fhunleth/scratchcc/robot/cad/sidestrip.pdf

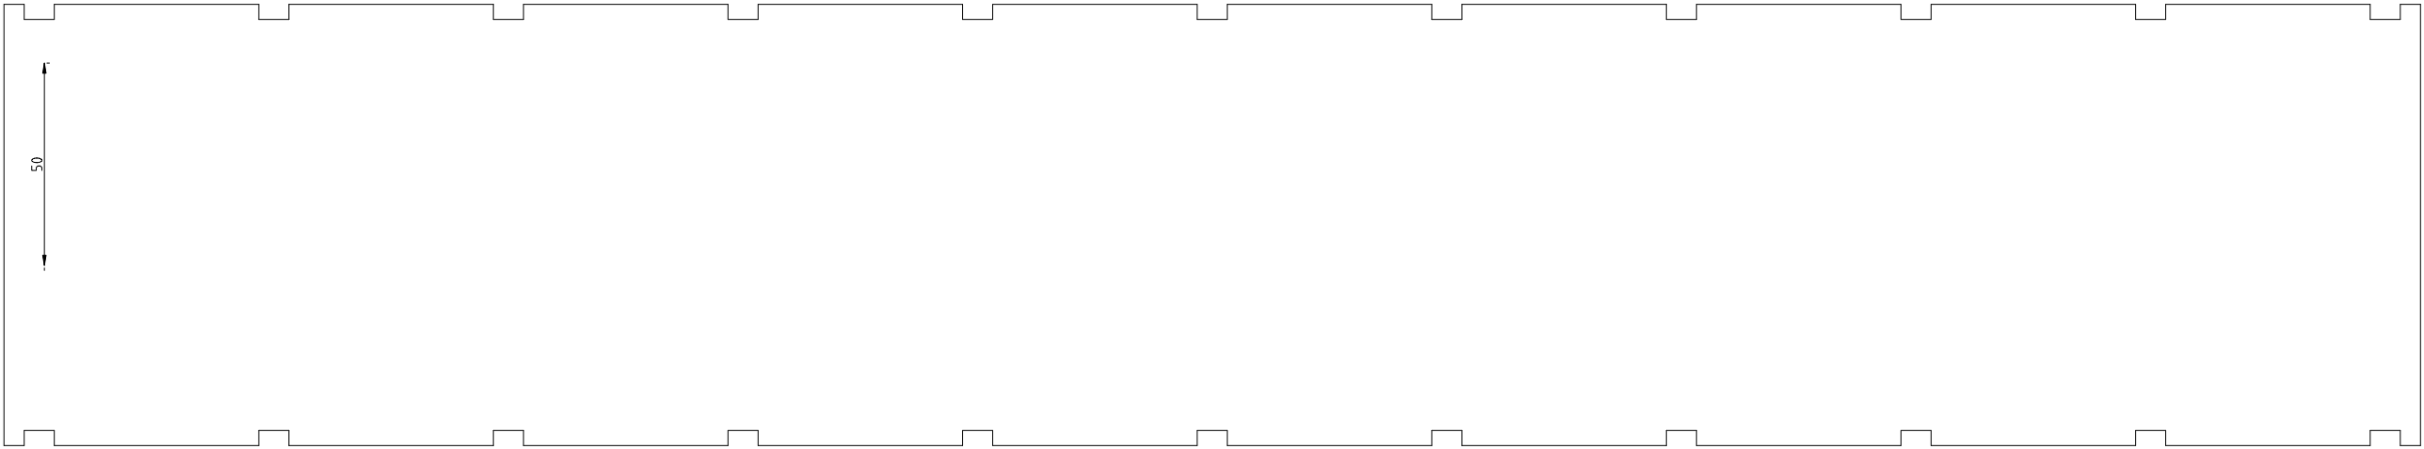
[picture p1: figure]
