fhunleth/scratchcc/robot/cad/batteryholder.dxf

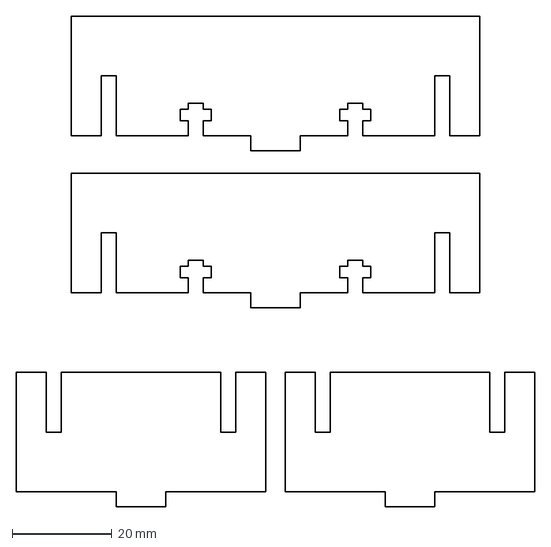
[picture p2: CAD file, 2014-07-11]
robot/cad/batteryholder.dxf
104.0 x 98.5 mm
