fhunleth/scratchcc/robot/cad/sidestrip.dxf

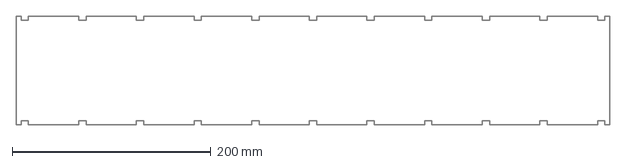
[picture p3: CAD file, 2014-07-11]
robot/cad/sidestrip.dxf
598.1 x 109.1 mm
