fhunleth/scratchcc/robot/cad/robottop.dxf

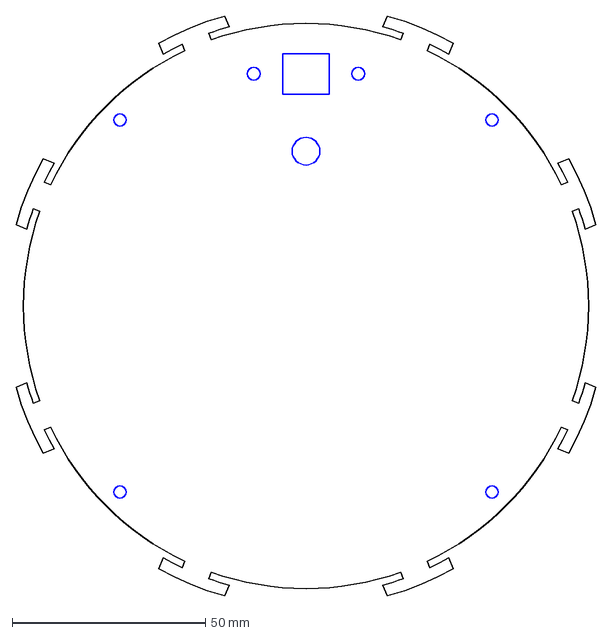
[picture p4: CAD file, 2014-07-09]
robot/cad/robottop.dxf
149.8 x 149.8 mm
