fhunleth/scratchcc/robot/cad/robotbase.dxf

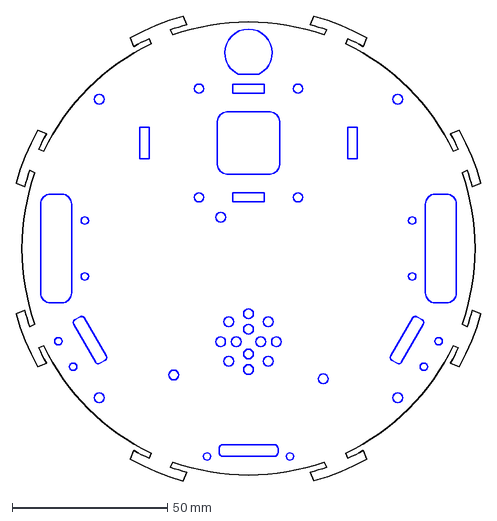
[picture p5: CAD file, 2014-07-09]
robot/cad/robotbase.dxf
149.8 x 149.8 mm
