fhunleth/scratchcc/robot/cad/robotbase.pdf

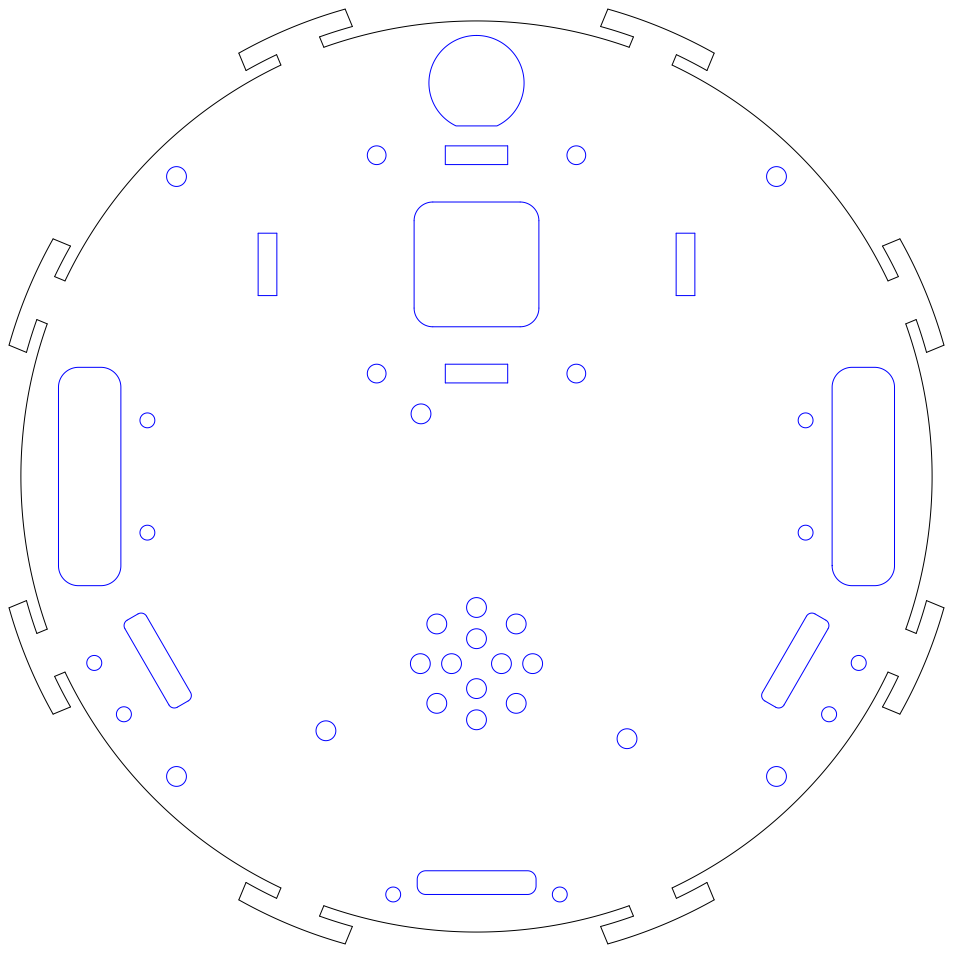
[picture p6: page 1]
