fhunleth/scratchcc/robot/cad/robottop.pdf

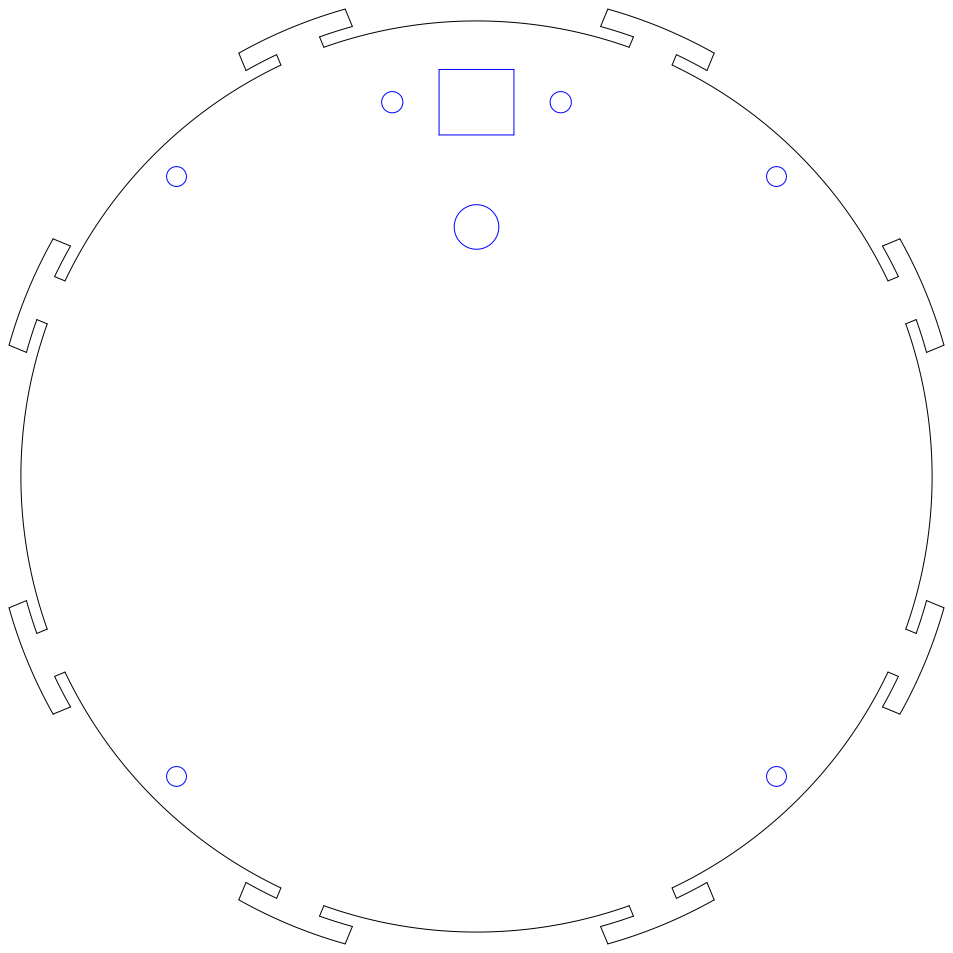
[picture p7: page 1]
