fhunleth/scratchcc/robot/shield/robot.brd

## EAGLE design robot/shield/robot.brd (2014-07-18)

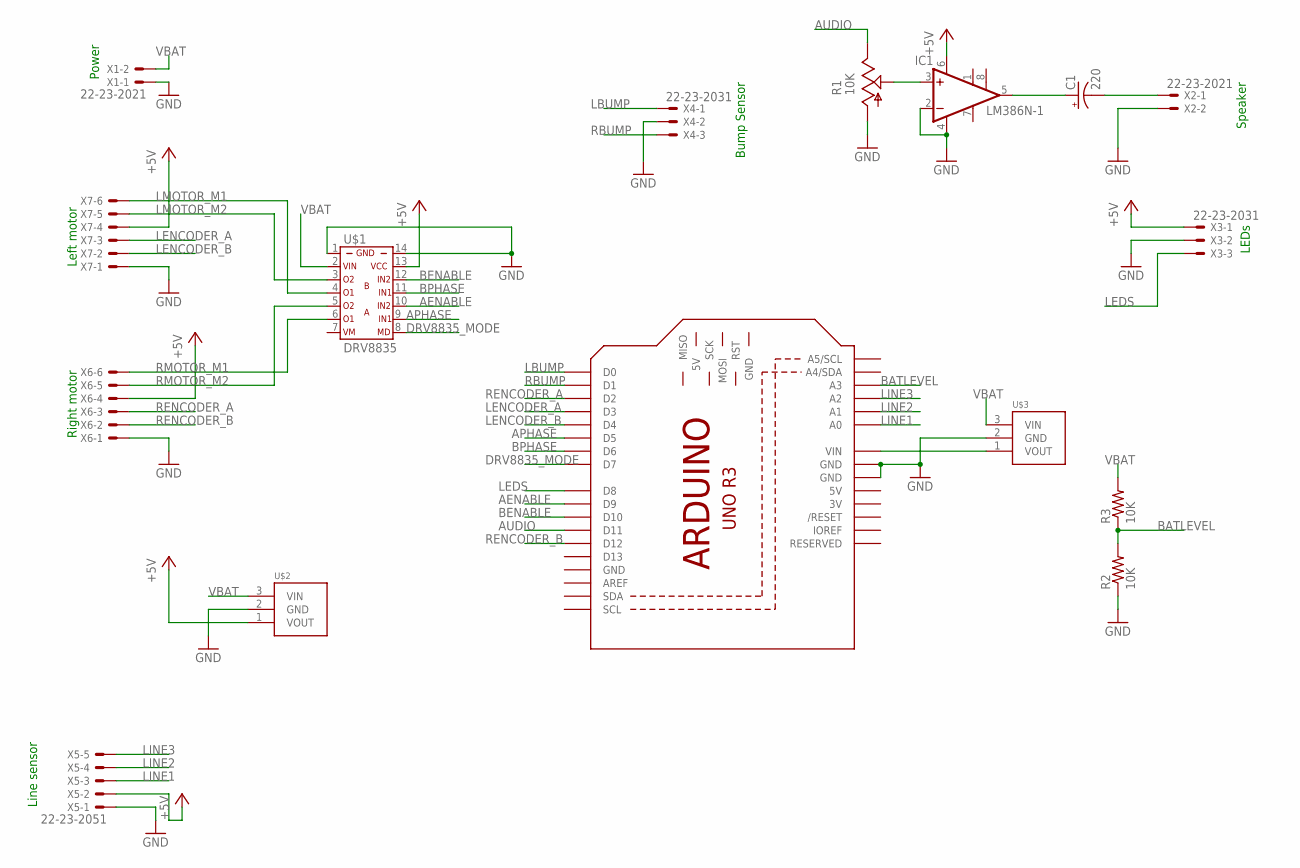
[picture p8: schematic robot.sch]

Parts:
C1: 220; E2,5-7
IC1: LM386N-1; DIL08
M2: ARDUINO_R3_ICSP; ARDUINOR3_ICSP
R1: 10K; S64W
R2, R3: 10K; V234/12
U$1: DRV8835; DIL14
U$2: S7V7F5; POLOLU-REG
U$3: U3V12F9; POLOLU-REG
X1, X2: 22-23-2021
X3, X4: 22-23-2031
X5: 22-23-2051
X6, X7: 22-23-2061

Connections:
3V: M2.3V
5V: M2.5V
+5V: IC1.6 (VS), U$1.13, U$2.1 (VOUT), X3.1, X5.2, X6.4, X7.4
AENABLE: M2.D9, U$1.10
APHASE: M2.D5, U$1.9
AUDIO: M2.D11, R1.E
BATLEVEL: M2.A3, R2.2, R3.1
BENABLE: M2.D10, U$1.12
BPHASE: M2.D6, U$1.11
DRV8835_MODE: M2.D7, U$1.8
GND: IC1.2 (-IN), IC1.4 (GND), M2.GND, M2.GND@1 (GND), M2.GND@3 (GND), R1.A, R2.1, U$1.1, U$1.14, U$2.2 (GND), U$3.2 (GND), X1.1, X2.2, X3.2, X4.2, X5.1, X6.1, X7.1
LBUMP: M2.D0, X4.1
LEDS: M2.D8, X3.3
LENCODER_A: M2.D3, X7.3
LENCODER_B: M2.D4, X7.2
LINE1: M2.A0, X5.3
LINE2: M2.A1, X5.4
LINE3: M2.A2, X5.5
LMOTOR_M1: U$1.4, X7.6
LMOTOR_M2: U$1.3, X7.5
unnamed: M2.VIN, U$3.1 (VOUT)
unnamed: C1.+, IC1.5 (OUT)
unnamed: IC1.3 (+IN), R1.S
unnamed: C1.-, X2.1
RBUMP: M2.D1, X4.3
RENCODER_A: M2.D2, X6.3
RENCODER_B: M2.D12, X6.2
RMOTOR_M1: U$1.6, X6.6
RMOTOR_M2: U$1.5, X6.5
VBAT: R3.2, U$1.2, U$2.3 (VIN), U$3.3 (VIN), X1.2

Notes on the sheet:
Left motor
Right motor
Speaker
LEDs
Line sensor
Power
Bump Sensor

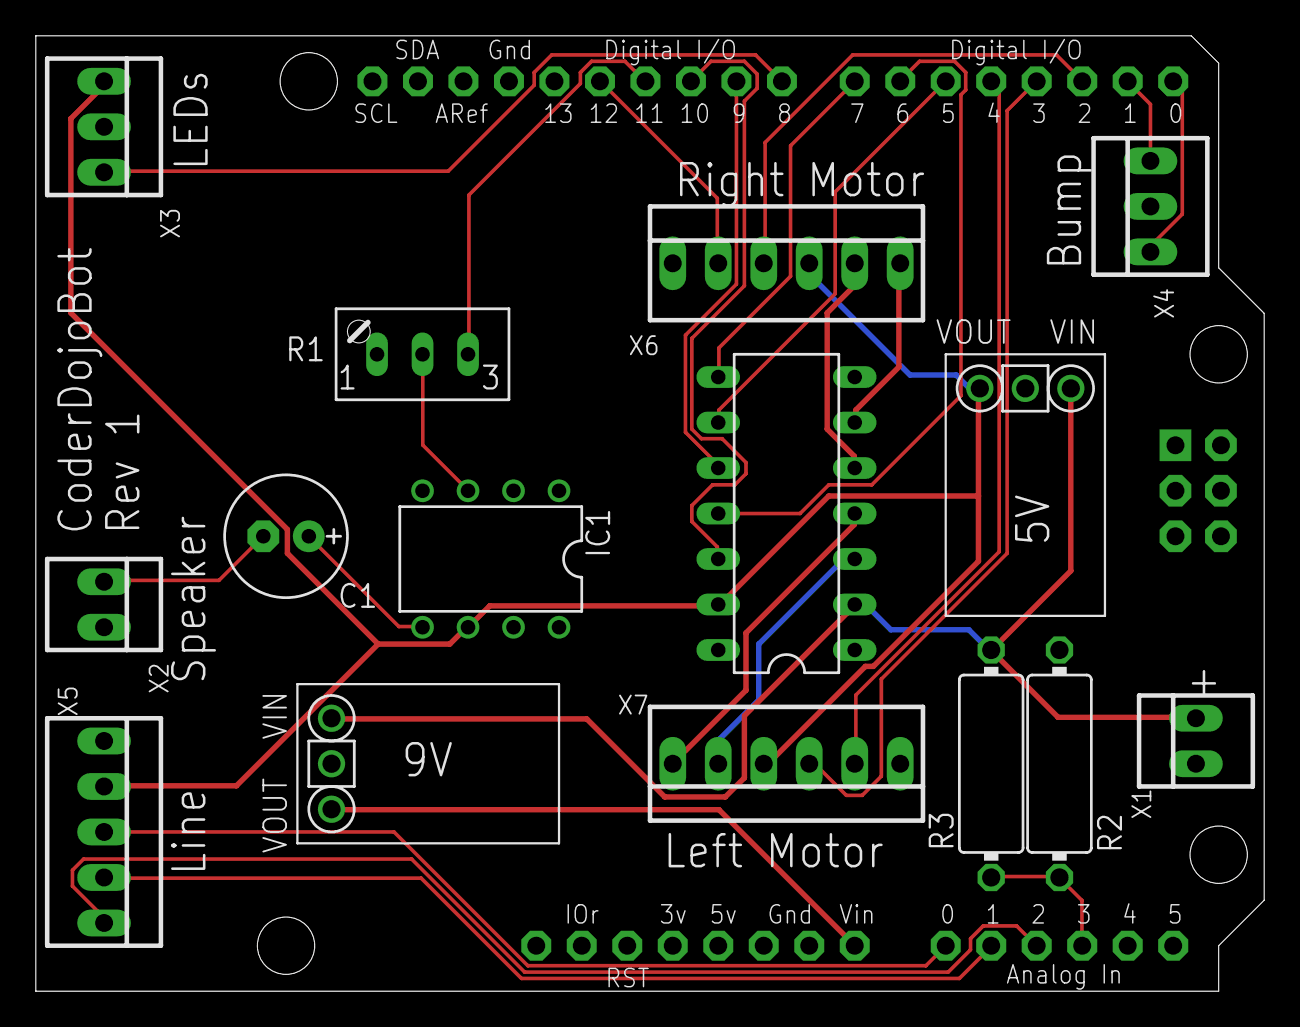
[picture p9: board robot.brd from above]

Board: 2 copper layers, 68.6 x 53.3 mm, 16 parts (0 on the bottom side), 28 nets.
