fhunleth/scratchcc/(commit log)

2014-06-21 Battery holder updates and side fix
    [batteryholder.dxf, robotbase.dxf, sidestrip.dxf]
2014-06-22 Add hole to push battery out; update pdfs
    [robotbase.dxf]
2014-07-04 Added whisker sensor mounts
    [robotbase.dxf]
2014-07-06 Add shield schematics and layout
    [robot.brd, robot.sch]
2014-07-09 Various fixes after laser cutting first pieces
    [batteryholder.dxf, calculations.xlsx, robotbase.dxf, robottop.dxf, sidestrip.dxf]
2014-07-09 Add laser cutter notes
2014-07-09 Add note about xps cropping on laser cutter
2014-07-10 Make battery holder walls wider to prevent them from breaking
    [batteryholder.dxf]
2014-07-11 Add dimension to printout to test scale on printouts
    [sidestrip.dxf]
2014-07-11 Update pdfs to latest
    [batteryholder.dxf]
2014-07-15 Update pin assignments; layout
    [robot.brd, robot.sch]
2014-07-17 Updates to schematic and layout
    [robot.brd, robot.sch]
2014-07-18 Board version that was sent to OSH Park
    [robot.brd]
2014-09-02 Add some notes for when we respin the board
